dren-dk/SensorCtrl/eagle-sensor-ctrl/parts-2.txt

Partlist 

Exported from sensor-ctrl.sch at  8/09/2007 23:25:03 

EAGLE Version 4.16r2 Copyright (c) 1988-2006 CadSoft

Part     Value          Device          Package      Library      Sheet

C4       12pF           C-EU025-024X044 C025-024X044 rcl          1
C5       12pF           C-EU025-024X044 C025-024X044 rcl          1

C1       100nF          C-EU050-025X075 C050-025X075 rcl          1
C2       100nF          C-EU050-025X075 C050-025X075 rcl          1
C7       100nF          C-EU050-025X075 C050-025X075 rcl          1
C15      100nF          C-EU050-025X075 C050-025X075 rcl          1
C16      100nF          C-EU050-025X075 C050-025X075 rcl          1
C17      100nF          C-EU050-025X075 C050-025X075 rcl          1
C18      100nF          C-EU050-025X075 C050-025X075 rcl          1

C6       1uF            CPOL-EUE2,5-6E  E2,5-6E      rcl          1
C8       1uF            CPOL-EUE2,5-6E  E2,5-6E      rcl          1
C9       1uF            CPOL-EUE2,5-6E  E2,5-6E      rcl          1
C10      1uF            CPOL-EUE2,5-6E  E2,5-6E      rcl          1

C3       33uF           CPOL-EUE2.5-7   E2,5-7       rcl          1

C14      humidity       C-EU025-060X050 C025-060X050 rcl          1

IC1      ATMEGA88-20P   ATMEGA88-20P    DIL28-3      avr          1
IC2      78L05Z         78L05Z          TO92         linear       1
IC4      MAX232         MAX232          DIL16        maxim        1

JP2                     PINHD-2X5       2X05         pinhead      1

LED2                    LED3MM          LED3MM       led          1
LED3                    LED3MM          LED3MM       led          1
LED4                    LED3MM          LED3MM       led          1

Q1       20MHz          XTAL/S          QS           special      1

R4       330            R-EU_0204/2V    0204V        rcl          1
R6       330            R-EU_0204/2V    0204V        rcl          1
R7       330            R-EU_0204/2V    0204V        rcl          1

R2       2k             R-EU_0204/2V    0204V        rcl          1
R3       2k             R-EU_0204/2V    0204V        rcl          1
R5       2k             R-EU_0204/2V    0204V        rcl          1
R1       10k            R-EU_0204/2V    0204V        rcl          1
R8       10k            R-EU_0204/2V    0204V        rcl          1
R9       10k            R-EU_0204/2V    0204V        rcl          1
R10      10k            R-EU_0204/2V    0204V        rcl          1

R11      100k           R-EU_0204/2V    0204V        rcl          1

R12      10M            R-EU_0204/2V    0204V        rcl          1

SV1      ISP6           MA03-2          MA03-2       con-lstb     1
SV2      i2c            MA03-2          MA03-2       con-lstb     1
SV3                     MA03-2          MA03-2       con-lstb     1

U$5      LM75           LM75            SO8          lm75         1

X1                      W237-102        W237-102     con-wago-500 1
PWR                     W237-4          W237-4       con-wago-500 1
