dren-dk/SensorCtrl/eagle-sensor-ctrl/parts.txt

Stik:
 fladkabel 10 leder               30m x 55-660-13
 IDC      6                       12  x 43-150-08
 IDC      10                      4   x 43-150-16
 2x3 header                       25  x 43-717-12
 2x5 header                       8   x 43-717-38 
 Skrue termnial                   24  x 48-450-38

Kondensatorer:
 12pF           C-EU025-024X044   16  x 65-848-25
 100nF          C-EU050-025X075   100 x 65-226-84
 1uF            CPOL-EUE2,5-6E    100 x 67-165-34
 33uF           C-POL-EU2.5-7     25  x 67-164-27
 100nF smd 0805                   25  x 65-766-31

IC'er:
 78L05Z                           10  x 73-264-08
 MAX232                           8   x 73-023-26
 ATMEGA88-20P                     8   x 73-647-06
 LM75                             30  x 73-268-28

Modstande:
 2k                               100 x 60-726-07
 10k                              100 x 60-734-23
 100k                             20  x 60-745-61 
 10M                              20  x 60-759-49

Diverse:
 SMTHS 07                         8   x 73-087-49
 Krystal    20MHz                 8   x 74-517-19
 LED 3mm                          25  x 75-053-40
 Gummi fødder 3mm                 1   x 48-865-60
