dren-dk/SensorCtrl/eagle-sensor-ctrl/sensor-ctrl.pdf

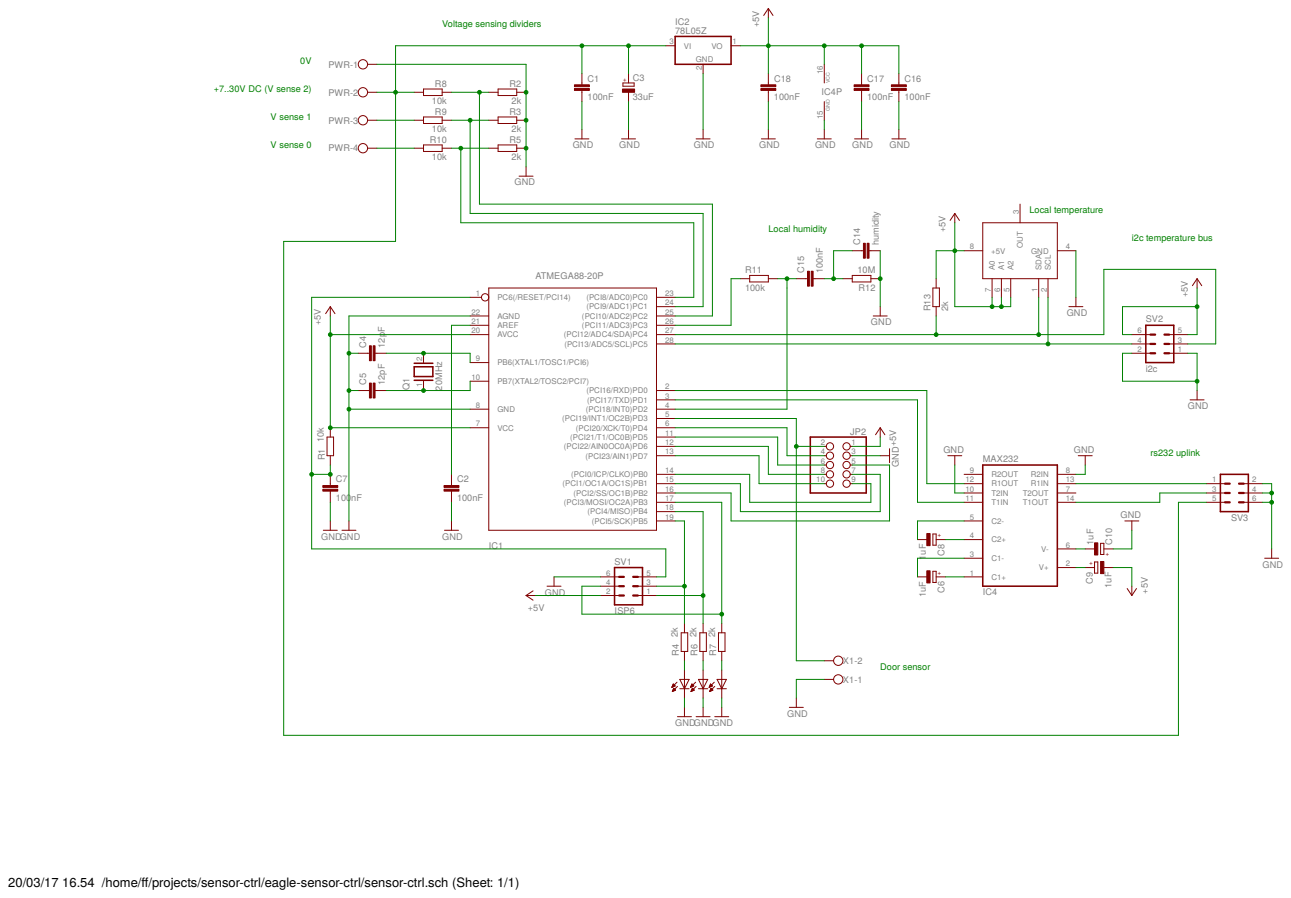
[picture p1: page 1]

26 | GND

20/03/17 16.54 /home/ff/projects/sensor-ctrl/eagle-sensor-ctrl/sensor-ctrl.sch (Sheet: 1/1)
